MartinVoelz/passive-toolchanger/magnet-wheel-toolchanger/fabrication_exports/carrier/carrier_base_plate.stl

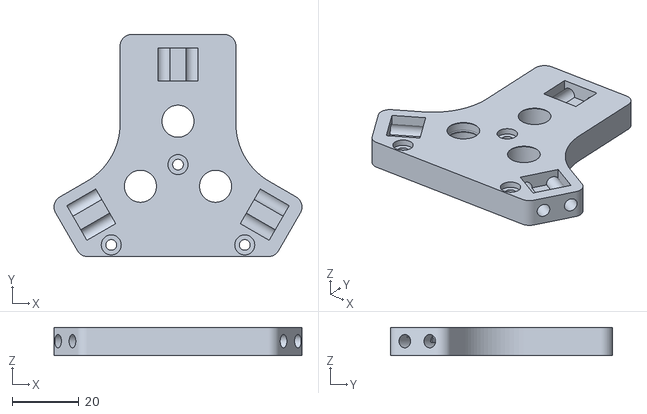
[picture p7: CAD file, 2022-04-30]
magnet-wheel-toolchanger/fabrication_exports/carrier/carrier_base_plate.stl
74.3 x 66.6 x 8.40
