MartinVoelz/passive-toolchanger/magnet-wheel-toolchanger/fabrication_exports/parking_post/parking_post_base_77_original_jubilee.stl

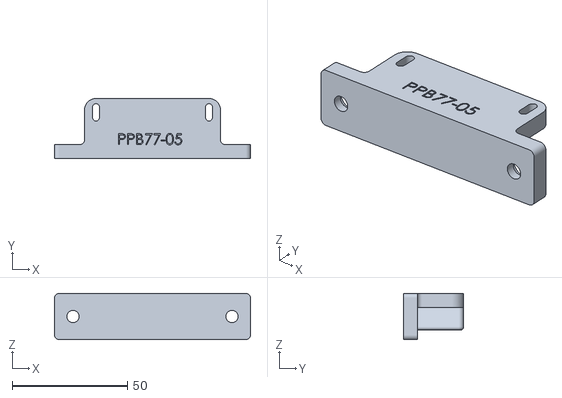
[picture p8: CAD file, 2022-04-30]
magnet-wheel-toolchanger/fabrication_exports/parking_post/parking_post_base_77_original_jubilee.stl
85.0 x 26.0 x 20.0
