MartinVoelz/passive-toolchanger/magnet-wheel-toolchanger/slicer_projects/Easythreed_K1_magnet_wheel.3mf

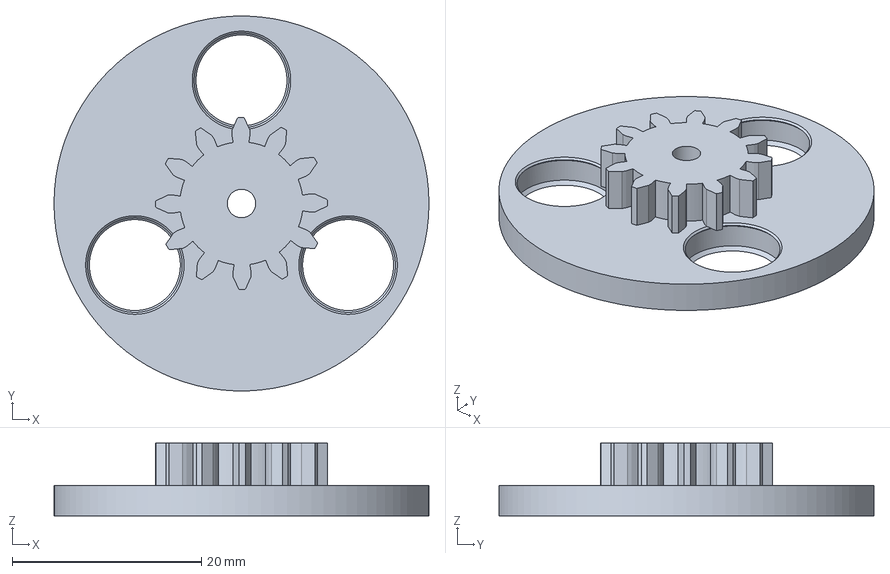
[picture p10: CAD file, 2022-04-30]
magnet-wheel-toolchanger/slicer_projects/Easythreed_K1_magnet_wheel.3mf
39.6 x 39.6 x 7.70 mm
