MartinVoelz/passive-toolchanger/magnet-wheel-toolchanger/fabrication_exports/carrier/carrier_center.stl

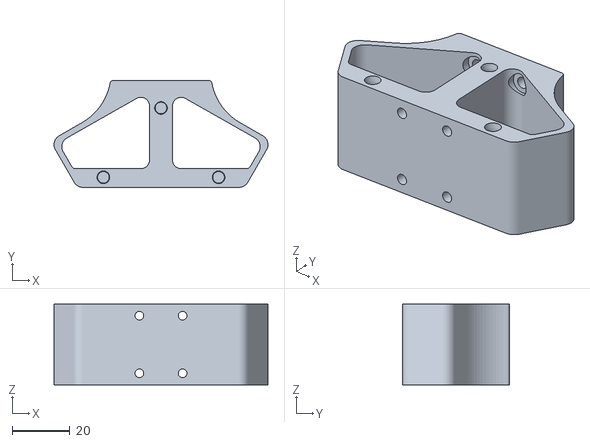
[picture p11: CAD file, 2022-04-30]
magnet-wheel-toolchanger/fabrication_exports/carrier/carrier_center.stl
74.3 x 37.1 x 28.0
