MartinVoelz/passive-toolchanger/magnet-wheel-toolchanger/fabrication_exports/parking_post/parking_post_toolholder_77_original_jubilee.stl

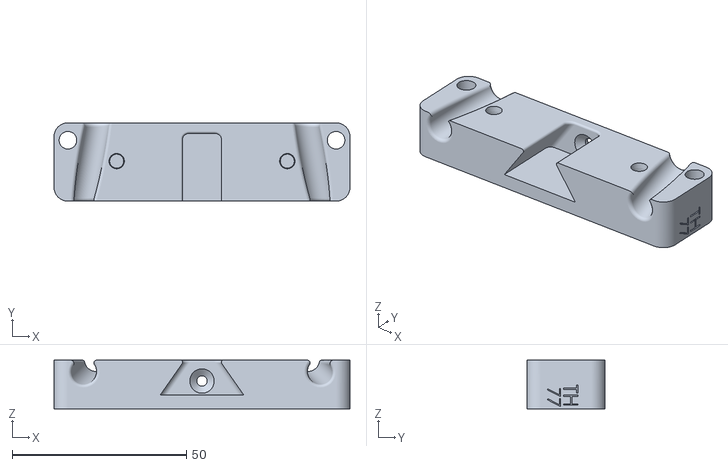
[picture p12: CAD file, 2022-04-30]
magnet-wheel-toolchanger/fabrication_exports/parking_post/parking_post_toolholder_77_original_jubilee.stl
85.0 x 22.5 x 14.0
