MartinVoelz/passive-toolchanger/magnet-wheel-toolchanger/fabrication_exports/tool_template/tool_mount_plate.stl

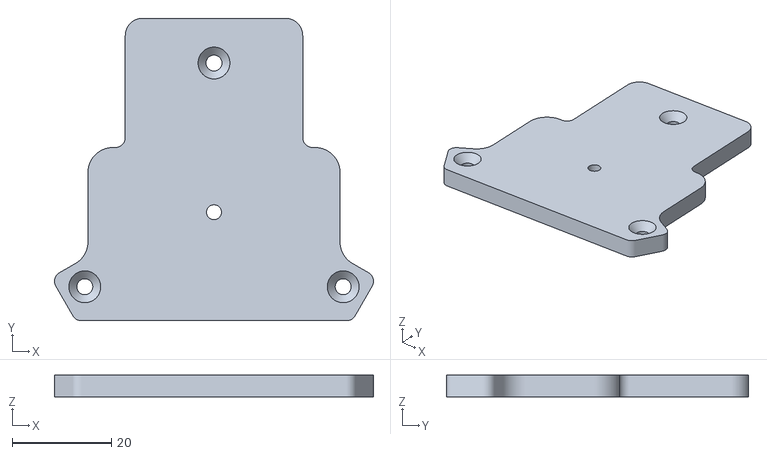
[picture p13: CAD file, 2022-04-30]
magnet-wheel-toolchanger/fabrication_exports/tool_template/tool_mount_plate.stl
64.2 x 60.8 x 4.40
