MartinVoelz/passive-toolchanger/magnet-wheel-toolchanger/slicer_projects/Easythreed_K1_tool_both_wings.3mf

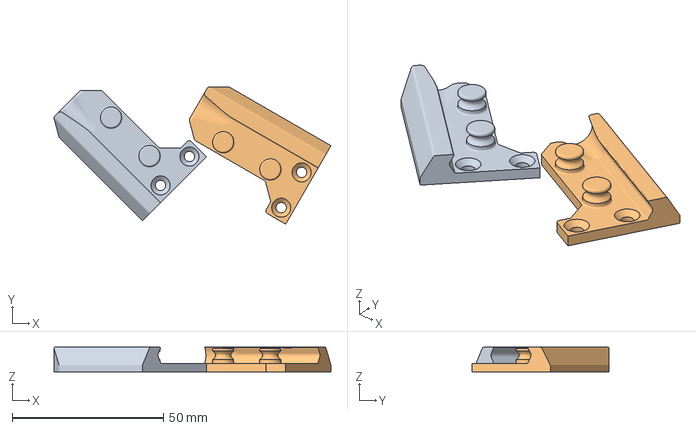
[picture p14: CAD file, 2022-04-30]
magnet-wheel-toolchanger/slicer_projects/Easythreed_K1_tool_both_wings.3mf
91.7 x 45.5 x 8.20 mm
tool_left_wing.stl
tool_right_wing.stl
