MartinVoelz/passive-toolchanger/magnet-wheel-toolchanger/fabrication_exports/tool_template/tool_right_wing.stl

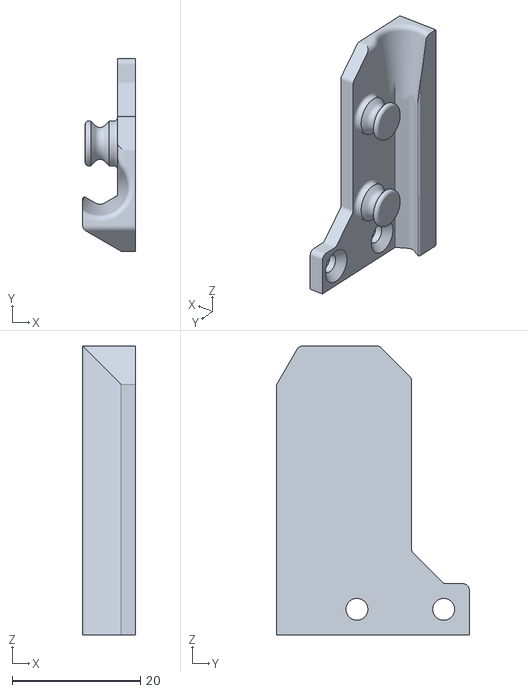
[picture p15: CAD file, 2022-04-30]
magnet-wheel-toolchanger/fabrication_exports/tool_template/tool_right_wing.stl
8.20 x 30.0 x 45.0
