MartinVoelz/passive-toolchanger/magnet-wheel-toolchanger/slicer_projects/Easythreed_K1_tool_cograil_slider.3mf

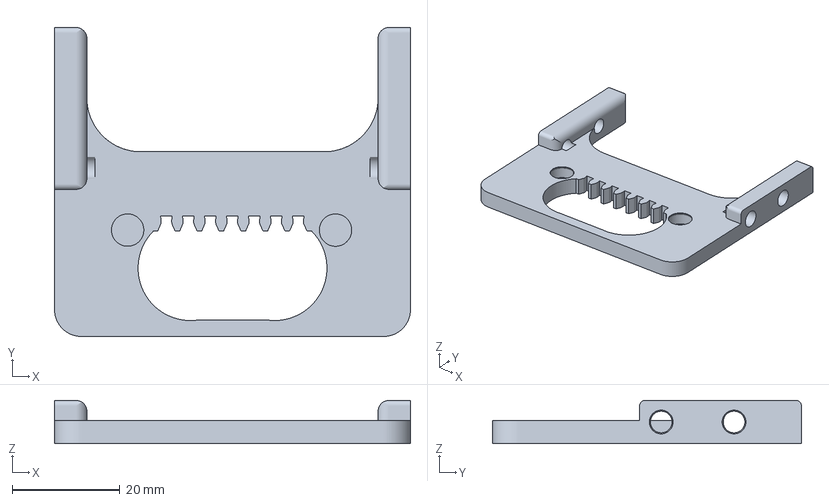
[picture p16: CAD file, 2022-04-30]
magnet-wheel-toolchanger/slicer_projects/Easythreed_K1_tool_cograil_slider.3mf
66.0 x 57.3 x 8.00 mm
