MartinVoelz/passive-toolchanger/magnet-wheel-toolchanger/fabrication_exports/tool_template/tool_wings_compression_flexture_negative.stl

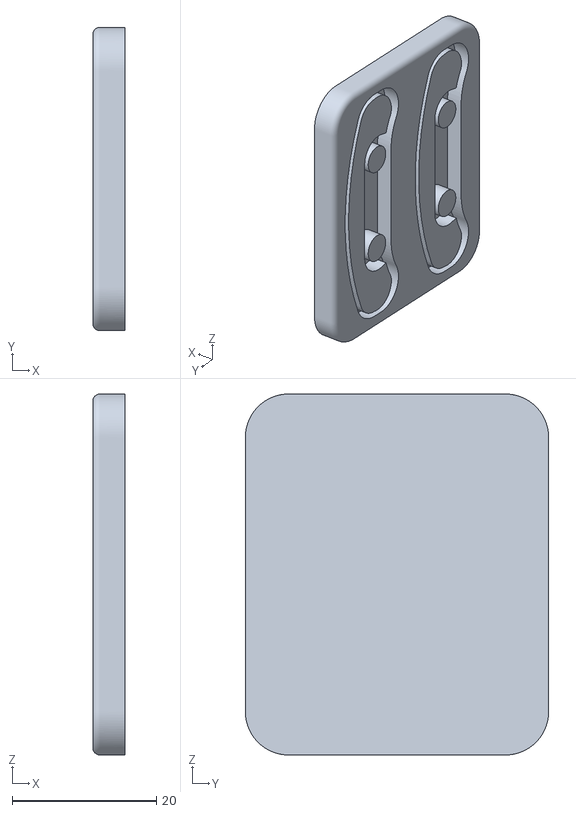
[picture p17: CAD file, 2022-04-30]
magnet-wheel-toolchanger/fabrication_exports/tool_template/tool_wings_compression_flexture_negative.stl
4.50 x 42.0 x 50.0
