MartinVoelz/passive-toolchanger/magnet-wheel-toolchanger/slicer_projects/Easythreed_K1_jubilee_parking_post_77.3mf

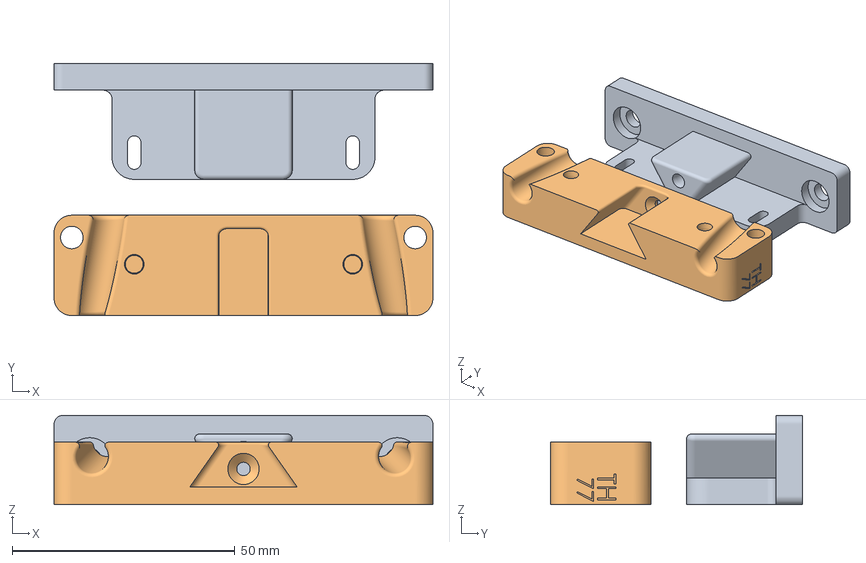
[picture p18: CAD file, 2022-04-30]
magnet-wheel-toolchanger/slicer_projects/Easythreed_K1_jubilee_parking_post_77.3mf
85.0 x 56.5 x 20.0 mm
parking_post_base_77_original_jubilee.stl
parking_post_toolholder_77_original_jubilee.stl
