MartinVoelz/passive-toolchanger/(list of files, cad)

Other CAD files:
magnet-wheel-toolchanger/fabrication_exports/tool_template/tool_magnet_wheel.stl
magnet-wheel-toolchanger/slicer_projects/Easythreed_K1_carrier_base_plate.3mf
magnet-wheel-toolchanger/slicer_projects/Easythreed_K1_tool_base_plate.3mf
magnet-wheel-toolchanger/fabrication_exports/tool_template/tool_left_wing.stl
magnet-wheel-toolchanger/slicer_projects/Easythreed_K1_carrier_center.3mf
magnet-wheel-toolchanger/fabrication_exports/tool_template/tool_cograil_slider.stl
magnet-wheel-toolchanger/slicer_projects/Easythreed_K1_tool_wings_compression_flexture_negative.3mf
magnet-wheel-toolchanger/slicer_projects/Easythreed_K1_tool_mount_plate.3mf
