MartinVoelz/passive-toolchanger/(commit log)

2022-04-27 Update README.md
    add link to magnet-wheel-toolchanger
2022-04-30 Add files via upload
    initial CAD and fabrication exports
    [Easythreed_K1_carrier_base_plate.3mf, Easythreed_K1_carrier_center.3mf, Easythreed_K1_jubilee_parking_post_77.3mf, Easythreed_K1_magnet_wheel.3mf, Easythreed_K1_tool_base_plate.3mf, Easythreed_K1_tool_both_wings.3mf, Easythreed_K1_tool_cograil_slider.3mf, Easythreed_K1_tool_mount_plate.3mf]
